SoumilBhandari/Neural-Space-Cap-Hardware/docs/DESIGN_NOTES.md

# Design notes

Why the parts are shaped the way they are, and what is still unverified.

## The head model is an ellipsoid, and says so

Three tape measurements solve for three semi-axes, so the model reproduces the
arcs it was fitted from exactly. It has no brow, no occipital bump, and perfect
left-right symmetry, none of which a real head has.

That is a defensible approximation for placing holders on a fabric cap, which
has a few millimetres of give anyway. What makes it honest rather than sloppy
is that the tool reports its own error: the 10-20 standard fixes T7 twice over,
by two different arcs, and how far apart those land is a direct measure of how
ellipsoid-like this particular head is. Across the range of heads tested it
comes out at 1-2 mm. Above 5 mm the tool tells the operator to stop trusting it
and mark by tape.

## Why a spider spring and not a foam pad

The obvious way to hold an electrode against a scalp is a foam pad and a tight
cap. It does not work well: cap tension varies with how the cap is put on, it
is different at every site, and it drops as the fabric relaxes over a session.
The failure is silent — the recording just gets noisier.

The spider spring decouples contact pressure from cap tension. The rim is sewn
to the fabric, the hub floats on three spiral arms, and the arms set the load.
Every site gets the same pressure, and it stays the same for as long as the
subject wears it.

It also prints flat with no supports and no overhangs, which matters when the
team will print a dozen of them and iterate on the spring rate.

## The frame is generated, and that is the point

Nothing about the frame is drawn by hand. Three tape measurements produce an
ellipsoid, the ellipsoid produces the 10-20 arcs, and the arcs produce the band
paths that the frame sweeps along. A different head gives a different frame
from the same source file.

That is worth the extra machinery for one reason: a frame drawn once to fit one
person's head is a frame that fits one person. The team has six members and
will want to record more than one of them.

The mount rotations come out of the same model. The outward normal of an
ellipsoid at a point is just the gradient, and `nsc_fit` converts it into the
two rotations that stand an OpenSCAD cylinder up along it, so every electrode
socket points straight out of the skull rather than being eyeballed.

## The montage is the team's, not the textbook's

The frame carries the eight sites the team specified: Fpz, F3, F4, C3, Cz, C4,
P3 and P4. Three of those — F4, Cz and P3 — are wired first while the circuit
is a single channel, and their sockets stand 2.5 mm proud of the others so they
can be found by hand without a drawing.

Carrying them needed two more arches. F3, F4, P3 and P4 sit on neither the ring
nor either original arch, so the frame gained the standard frontal
(F7-F3-Fz-F4-F8) and parietal (P7-P3-Pz-P4-P8) chains. Both land on the ring at
their ends, so they brace it rather than hanging off it.

Those two chains are not planar ellipses — F3 and P3 are defined as lying
between two other sites, so the curve through them has no closed form.
Interpolating in a plane and projecting afterwards would sag the path inside
the skull between control points, so the path is interpolated on a unit sphere,
where the shortest route between two points is a great-circle arc with an exact
formula, and mapped back onto the ellipsoid afterwards.

## The phase-one marker moved twice

First attempt: a sphere on the side of the socket boss, at boss_d/2 - 1.5.
That is inside the boss radius, so it rendered, existed in the mesh, and was
completely invisible and unfeelable.

Second attempt: the same sphere at boss_d/2 + 0.5, standing proud. That works
at some sockets and not others, because the nub points along whatever direction
the socket's local frame happens to face, and at Fpz and Cz that is straight
into a band.

What is there now: a collar extending along the socket axis, away from the
skull, where no band ever reaches. `tests/test_frame_geometry.py` measures
axial reach to confirm it, because a radial measurement cannot tell a collar
from the band the socket is sitting on.

## The LiDAR scan settled the swapped measurements

The tape numbers recorded in the team chat were 575 mm circumference, 340 mm
front-to-back and 350 mm ear-to-ear. Fitted as written they produce a head
wider across than it is long, which is unusual, and the suspicion was that the
two arc measurements had been swapped.

A LiDAR scan of the same head answers it. Principal-component analysis of the
cranium gives a long axis running front to back with a 1.14 ratio over the
short axis — longer than it is wide, the normal proportion. The measurements
were swapped. The fit uses 350 front-to-back and 340 ear-to-ear.

## Hair makes a scan a poor source of head size

The same scan is almost useless for sizing. A convex hull taken round the head
at ring height — which is what a tape measure actually follows, since a tape
bridges every dip rather than tracking into it — reads about 790 mm, against
575 mm measured by tape on the scalp. The difference is hair, and it is
200 mm of circumference, or three centimetres of radius everywhere.

How far hair compresses under a cap is not something the scan can tell us, and
it is the only number that decides whether the frame fits. So the frame ships
as a size run rather than a single part: four sizes a fixed percentage apart,
printed together, and whichever one sits right is the one that gets used. That
is cheaper than one more round of measuring, and it is the honest response to
a quantity nobody can predict.

## The divot: a tangent cut has no room for chord sag

The first scan-fitted frames had bites taken out of the bands, worst beside
the sockets — pinched waists that read as damage rather than design.

A band is swept as a hull of spheres at consecutive path points, so between
two points its surface is a straight chord, and a chord across a curve sags
inward. The band centreline was placed exactly on the surface it is cut
against, which makes the cut tangent to the centreline and leaves that sag
nowhere to go: anywhere the chord dipped, the subtraction ate into the band.
Measured sag was 0.70 mm around the lateral ring and 1.23 mm on the sagittal
arch, against a 5.5 mm band radius.

Two changes. Band paths are sampled twice as densely, which shrinks sag
quadratically; and the centreline now stands off by the liner gap plus a
1.5 mm margin, so the chord never reaches the cut. Every band now clears it
by at least 0.79 mm. The inner face is still flat against the head — the band
simply sits a little prouder of it.

The general lesson is the same one the index nub and the size badge taught:
placing a feature exactly on a boundary is placing it on the wrong side of
that boundary half the time.

## The scan has a dropout on her right, and it put a dent in the frame

A hand-held scan rarely closes evenly on both sides of a head. This one lost
her right-front quadrant, and where the data thinned the reconstruction
collapsed inward — up to 17.7 mm inside its own mirror image, smoothly across
the whole region. A skull does not do that; a scanner losing tracking does.
Unrepaired it put a visible dent in the lateral ring.

`nsc_fit.scanned.symmetrize` mirrors the height field across the sagittal
plane and keeps the larger of each pair. Larger rather than average, because a
dropout is a spurious inward collapse: the intact side carries the true
radius, and erring outward gives a cap that is slightly loose rather than one
that will not go on. Worst asymmetry after repair is 0.0 mm.

The cost is that genuine left-right asymmetry is flattened with it. For a cap
that is the right trade, but it does mean the repaired surface is no longer
purely measured, and it is why `repair_dropout` is a flag rather than
something done silently.

## A scan measures hair, and hair is not what a cap sits on

The LiDAR reads about 800 mm around the ring line. Tape on her scalp reads
575 mm. That is 36 mm of loft everywhere — a scanner recording dark hair where
it lies, uncompressed, which is not the surface a cap rests on because a cap
presses through it.

Built to the raw figure the frame came out 282 mm across: too big for any
hobby printer, and it would sit on her head like a lampshade.
`ScannedHead.scaled_to` keeps her contour — every bump, the slope of her
occiput, all of it still hers — and sets only how much hair the frame expects
to flatten.

How much that is, nobody can predict, so `make scan-sizes` prints a run.
Measured sizes, including bands and sockets:

| ring circumference | hair allowance | frame | 220 bed | 250 bed |
|---|---|---|---|---|
| 600 mm |  4.0 mm | 202 x 217 mm | no room | yes |
| 620 mm |  7.2 mm | 208 x 223 mm | no | yes |
| 640 mm (default) | 10.3 mm | 214 x 229 mm | no | yes |
| 660 mm | 13.5 mm | 220 x 236 mm | no | yes |

**Nothing that clears her hair fits a 220 mm bed.** A 250 mm machine takes any
of them. The alternative is to tie the hair back or put a thin swim cap under
it and rescan, which drops the frame to roughly 190 mm and prints anywhere.

## Two bugs the size sweep exposed

**A NaN that OpenSCAD accepted.** Surface normals are estimated by finite
differences, and at the crown the azimuthal derivative vanishes, so the cross
product is the zero vector and normalising it gives NaN. `rotate([0, nan,
nan])` does not error — it silently produces garbage, and Cz is exactly where
four bands meet, so the garbage split the frame. It fell back to the radial
direction, which at the pole is the correct normal anyway, and the build now
refuses to run if any generated parameter is NaN.

**Specks that made every connectivity check lie.** CSG where the pod pad met
the ring left four loose shells of a few triangles each, none bigger than a
quarter of a millimetre. A slicer ignores them, but they made the part report
as five pieces and buried the only question that matters — whether the frame
itself is in one piece. Sinking the pad removed the cause, and
`nsc_fit.stlclean` drops any that remain.

## The frame printed in OpenSCAD and failed in the slicer

The first STLs went into a slicer and came back with warnings about non-manifold edges and
overhangs. OpenSCAD had reported every one of those meshes as a valid
manifold, and it was right about the mesh it held in memory.

An STL has no shared vertices. It is a list of loose triangles, and the
slicer rebuilds the surface by welding corners that sit at the same position.
The frame had 89,764 vertices and 45,689 of them sat exactly on top of
another one. In memory those were separate surfaces passing through each
other's corners. After welding they were edges with four triangles on them.

Cutting the build down one piece at a time found the source: the doubling
only appeared once the scanned head was subtracted. The head mesh had a
signed volume of minus 4648 cm³. It was inside out. A boolean engine will
still subtract an inverted solid, and what comes back looks correct on
screen and is wrong everywhere the two surfaces met.

Flipping the winding took the doubled vertices from 45,689 to 49. The last
49 were all one kind of mistake, two features meeting exactly: bands of equal
diameter crossing, a collar starting on the plane its boss ended on, the size
badge starting on the pad face. Each band is now a single tube mesh with its
own radius, the boss is one cylinder, and the badge starts 0.4 mm inside the
pad.

The overhang half was the print feet. They held the ring off the bed, so the
whole ring was a bridge between eight pads. The ring is now planar with its
underside cut flat, which is a better first layer than the feet were and
needs nothing removed afterwards. Overhang past 45 degrees went from 16% of
the surface to about 10%, and what is left is the underside of the arches
near the crown, which a dome printed ring-down will always have.

One notice survived all of that. PrusaSlicer's tree supports reported a lost
branch on three of the four sizes. Cutting the frame into boxes and slicing
each one walked it down to the back pad, and slicing a frame with no size
number made it go away. The number stood 1.2 mm proud of a face tilted 62
degrees, so every stroke of every digit was a tiny overhang with nowhere for
a support to land. It is engraved two layers deep now, and sized to fit the
strip of pad between its edge and the band, where before it ran off one side
and under the band on the other. All four sizes slice with nothing reported.

What changed in the process matters more than the fix. The build now checks
the exported file the way a slicer reads it, welded by position, and stops if
it is not one closed shell. Every size and every small part is then sliced
before it is handed to anyone.

## Splitting the frame is not solved

The frame is 172 x 202 x 128 mm, which fits a 220 mm bed but not every printer,
and it needs supports under both arches.

The obvious fix — cut it in half — does not work. The sagittal arch lies
exactly in the x = 0 plane and the coronal arch lies exactly in y = 0, so a cut
on either plane runs down an arch lengthwise and produces two half-pipes rather
than two halves of a frame. The first version of this part did exactly that.

Splitting it properly means cutting transversely at the four band junctions and
designing real joints there. Until that exists, print it whole.

## What the pod is not

It is a prototype enclosure, not a flight part. It is not sealed, not
shielded, and not rated for anything. It exists so the electronics stop being a
breadboard hanging off the back of someone's head, and so the demo looks like a
device rather than a science-fair project.

If shielding turns out to be needed — Dr. Porterfield suggested better
front-end filtering as the alternative to the team's foil Faraday cage — a
conductive coating on the inside of the shell, tied to the analog ground, is
the cheapest thing to try next.

## Open questions

- **Print tolerances are unverified.** Everything in `params.scad` came from
  datasheets and typical values, not from the team's printer. Print a coupon.
- **Spring rate is a guess.** `spring_t = 0.8` at 0.2 mm layers should give a
  comfortable press, but nobody has measured the force. Print three at 0.6,
  0.8 and 1.0 and pick by feel against a scalp.
- **Cable routing is not designed.** The pod has a gland and the holders have
  slots, but the path between them across the cap is not planned. Every wire
  that failed last semester failed where it left a connector unsupported.
- **Frame stiffness is untested.** A 10 to 11 mm swept band in PETG should be stiff
  enough for a ring braced by two arches, but nobody has worn one. If it flexes,
  the cheap fix is a wider band before a thicker one.
- **The frame and the sprung holder mount differently.** The holder has a sewn
  rim for a fabric cap; the frame has a press-fit socket. Both cannot be the
  answer, and which one wins should be decided after the first fit test.
- **The cap itself is not in this repository.** The fabric pattern, the sewing,
  and the head measurements from Spring are Jia's CAD work. This repository
  covers where things go on the cap and what holds them.
