SoumilBhandari/Neural-Space-Cap-Hardware/docs/images/cap_on_head_light.png

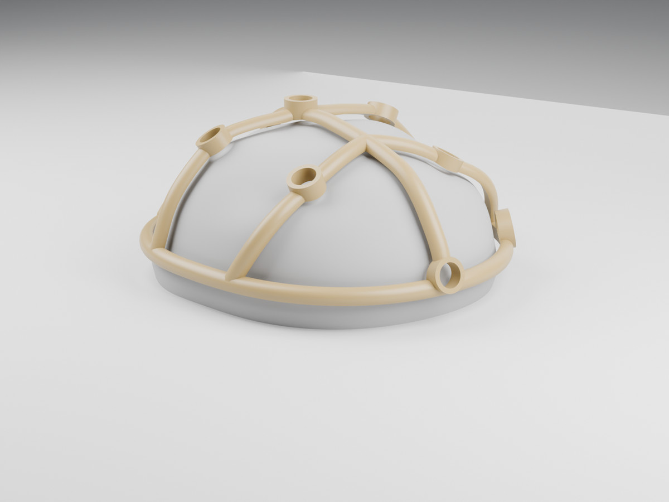
docs/images/cap_on_head_light.png
