SoumilBhandari/Neural-Space-Cap-Hardware/cad/head_params.scad

// Generated by nsc_fit — do not edit.
// Fitted from circumference 570 mm, nasion-inion 370 mm, ear-to-ear 350 mm.

head_axes = [83.409, 97.744, 136.221];
lateral_loop_len = 548.85;

band_lateral = [[-0.000, 94.117, 36.761], [-11.622, 93.127, 36.761], [-22.914, 90.205, 36.761], [-33.585, 85.493, 36.761], [-43.403, 79.190, 36.761], [-52.201, 71.526, 36.761], [-59.872, 62.733, 36.761], [-66.353, 53.028, 36.761], [-71.613, 42.609, 36.761], [-75.636, 31.653, 36.761], [-78.421, 20.318, 36.761], [-79.967, 8.749, 36.761], [-80.276, -2.919, 36.761], [-79.349, -14.554, 36.761], [-77.184, -26.024, 36.761], [-73.779, -37.188, 36.761], [-69.137, -47.896, 36.761], [-63.264, -57.982, 36.761], [-56.182, -67.257, 36.761], [-47.937, -75.514, 36.761], [-38.613, -82.526, 36.761], [-28.343, -88.062, 36.761], [-17.328, -91.900, 36.761], [-5.832, -93.869, 36.761], [5.832, -93.869, 36.761], [17.328, -91.900, 36.761], [28.343, -88.062, 36.761], [38.613, -82.526, 36.761], [47.937, -75.514, 36.761], [56.182, -67.257, 36.761], [63.264, -57.982, 36.761], [69.137, -47.896, 36.761], [73.779, -37.188, 36.761], [77.184, -26.024, 36.761], [79.349, -14.554, 36.761], [80.276, -2.919, 36.761], [79.967, 8.749, 36.761], [78.421, 20.318, 36.761], [75.636, 31.653, 36.761], [71.613, 42.609, 36.761], [66.353, 53.028, 36.761], [59.872, 62.733, 36.761], [52.201, 71.526, 36.761], [43.403, 79.190, 36.761], [33.585, 85.493, 36.761], [22.914, 90.205, 36.761], [11.622, 93.127, 36.761], [-0.000, 94.117, 36.761]];
band_sagittal = [[0.000, 94.117, 36.761], [0.000, 92.767, 42.912], [0.000, 91.198, 49.011], [0.000, 89.407, 55.049], [0.000, 87.390, 61.015], [0.000, 85.145, 66.898], [0.000, 82.666, 72.687], [0.000, 79.949, 78.368], [0.000, 76.989, 83.927], [0.000, 73.782, 89.346], [0.000, 70.324, 94.609], [0.000, 66.609, 99.693], [0.000, 62.634, 104.578], [0.000, 58.397, 109.236], [0.000, 53.897, 113.640], [0.000, 49.134, 117.759], [0.000, 44.113, 121.559], [0.000, 38.842, 125.003], [0.000, 33.334, 128.055], [0.000, 27.609, 130.674], [0.000, 21.691, 132.824], [0.000, 15.615, 134.472], [0.000, 9.418, 135.587], [0.000, 3.148, 136.150], [0.000, -3.148, 136.150], [0.000, -9.418, 135.587], [0.000, -15.615, 134.472], [0.000, -21.691, 132.824], [0.000, -27.609, 130.674], [0.000, -33.334, 128.055], [0.000, -38.842, 125.003], [0.000, -44.113, 121.559], [0.000, -49.134, 117.759], [0.000, -53.897, 113.640], [0.000, -58.397, 109.236], [0.000, -62.634, 104.578], [0.000, -66.609, 99.693], [0.000, -70.324, 94.609], [0.000, -73.782, 89.346], [0.000, -76.989, 83.927], [0.000, -79.949, 78.368], [0.000, -82.666, 72.687], [0.000, -85.145, 66.898], [0.000, -87.390, 61.015], [0.000, -89.407, 55.049], [0.000, -91.198, 49.011], [0.000, -92.767, 42.912], [0.000, -94.117, 36.761]];
band_coronal = [[-65.250, 0.000, 84.854], [-63.576, 0.000, 88.180], [-61.814, 0.000, 91.460], [-59.962, 0.000, 94.690], [-58.019, 0.000, 97.866], [-55.981, 0.000, 100.982], [-53.846, 0.000, 104.033], [-51.612, 0.000, 107.011], [-49.275, 0.000, 109.909], [-46.834, 0.000, 112.720], [-44.286, 0.000, 115.435], [-41.628, 0.000, 118.043], [-38.861, 0.000, 120.533], [-35.982, 0.000, 122.894], [-32.992, 0.000, 125.112], [-29.892, 0.000, 127.173], [-26.684, 0.000, 129.062], [-23.372, 0.000, 130.764], [-19.964, 0.000, 132.262], [-16.468, 0.000, 133.540], [-12.894, 0.000, 134.584], [-9.258, 0.000, 135.379], [-5.574, 0.000, 135.917], [-1.861, 0.000, 136.187], [1.861, 0.000, 136.187], [5.574, 0.000, 135.917], [9.258, 0.000, 135.379], [12.894, 0.000, 134.584], [16.468, 0.000, 133.540], [19.964, 0.000, 132.262], [23.372, 0.000, 130.764], [26.684, 0.000, 129.062], [29.892, 0.000, 127.173], [32.992, 0.000, 125.112], [35.982, 0.000, 122.894], [38.861, 0.000, 120.533], [41.628, 0.000, 118.043], [44.286, 0.000, 115.435], [46.834, 0.000, 112.720], [49.275, 0.000, 109.909], [51.612, 0.000, 107.011], [53.846, 0.000, 104.033], [55.981, 0.000, 100.982], [58.019, 0.000, 97.866], [59.962, 0.000, 94.690], [61.814, 0.000, 91.460], [63.576, 0.000, 88.180], [65.250, 0.000, 84.854]];
band_frontal = [[-66.646, 52.522, 36.761], [-65.045, 53.946, 40.238], [-63.365, 55.303, 43.666], [-61.606, 56.592, 47.040], [-59.772, 57.811, 50.356], [-57.864, 58.959, 53.610], [-55.885, 60.034, 56.798], [-53.837, 61.035, 59.916], [-51.722, 61.962, 62.960], [-49.544, 62.811, 65.927], [-47.305, 63.584, 68.812], [-45.008, 64.278, 71.613], [-42.655, 64.893, 74.325], [-40.250, 65.428, 76.946], [-37.795, 65.882, 79.472], [-35.293, 66.256, 81.900], [-32.748, 66.547, 84.227], [-30.163, 66.757, 86.451], [-27.540, 66.885, 88.568], [-24.884, 66.930, 90.576], [-22.197, 66.892, 92.472], [-19.482, 66.773, 94.255], [-16.744, 66.571, 95.921], [-13.985, 66.287, 97.469], [-11.209, 65.921, 98.898], [-8.419, 65.474, 100.204], [-5.618, 64.947, 101.387], [-2.811, 64.339, 102.445], [0.000, 63.652, 103.377], [2.811, 64.339, 102.445], [5.618, 64.947, 101.387], [8.419, 65.474, 100.204], [11.209, 65.921, 98.898], [13.985, 66.287, 97.469], [16.744, 66.571, 95.921], [19.482, 66.773, 94.255], [22.197, 66.892, 92.472], [24.884, 66.930, 90.576], [27.540, 66.885, 88.568], [30.163, 66.757, 86.451], [32.748, 66.547, 84.227], [35.293, 66.256, 81.900], [37.795, 65.882, 79.472], [40.436, 65.390, 76.748], [43.020, 64.804, 73.914], [45.543, 64.125, 70.974], [48.000, 63.354, 67.933], [50.389, 62.494, 64.795], [52.706, 61.543, 61.564], [54.948, 60.505, 58.246], [57.111, 59.381, 54.844], [59.193, 58.172, 51.364], [61.190, 56.879, 47.811], [63.099, 55.506, 44.189], [64.919, 54.053, 40.504], [66.646, 52.522, 36.761]];
band_parietal = [[-66.646, -52.522, 36.761], [-65.045, -53.946, 40.238], [-63.365, -55.303, 43.666], [-61.606, -56.592, 47.040], [-59.772, -57.811, 50.356], [-57.864, -58.959, 53.610], [-55.885, -60.034, 56.798], [-53.837, -61.035, 59.916], [-51.722, -61.962, 62.960], [-49.544, -62.811, 65.927], [-47.305, -63.584, 68.812], [-45.008, -64.278, 71.613], [-42.655, -64.893, 74.325], [-40.250, -65.428, 76.946], [-37.795, -65.882, 79.472], [-35.293, -66.256, 81.900], [-32.748, -66.547, 84.227], [-30.163, -66.757, 86.451], [-27.540, -66.885, 88.568], [-24.884, -66.930, 90.576], [-22.197, -66.892, 92.472], [-19.482, -66.773, 94.255], [-16.744, -66.571, 95.921], [-13.985, -66.287, 97.469], [-11.209, -65.921, 98.898], [-8.419, -65.474, 100.204], [-5.618, -64.947, 101.387], [-2.811, -64.339, 102.445], [0.000, -63.652, 103.377], [2.811, -64.339, 102.445], [5.618, -64.947, 101.387], [8.419, -65.474, 100.204], [11.209, -65.921, 98.898], [13.985, -66.287, 97.469], [16.744, -66.571, 95.921], [19.482, -66.773, 94.255], [22.197, -66.892, 92.472], [24.884, -66.930, 90.576], [27.540, -66.885, 88.568], [30.163, -66.757, 86.451], [32.748, -66.547, 84.227], [35.293, -66.256, 81.900], [37.795, -65.882, 79.472], [40.436, -65.390, 76.748], [43.020, -64.804, 73.914], [45.543, -64.125, 70.974], [48.000, -63.354, 67.933], [50.389, -62.494, 64.795], [52.706, -61.543, 61.564], [54.948, -60.505, 58.246], [57.111, -59.381, 54.844], [59.193, -58.172, 51.364], [61.190, -56.879, 47.811], [63.099, -55.506, 44.189], [64.919, -54.053, 40.504], [66.646, -52.522, 36.761]];

// [name, position, [rot_x, rot_y, rot_z], phase_one]
mounts = [
    ["Fpz", [0.000, 94.117, 36.761], [0, 78.630, 90.000], 0],
    ["F3", [-37.795, 65.882, 79.472], [0, 63.994, 128.230], 0],
    ["F4", [37.795, 65.882, 79.472], [0, 63.994, 51.770], 1],
    ["C3", [-56.603, 0.000, 100.054], [0, 56.466, 180.000], 0],
    ["Cz", [0.000, -0.000, 136.221], [0, 0.000, -90.000], 1],
    ["C4", [56.603, 0.000, 100.054], [0, 56.466, 0.000], 0],
    ["P3", [-37.795, -65.882, 79.472], [0, 63.994, -128.230], 1],
    ["P4", [37.795, -65.882, 79.472], [0, 63.994, -51.770], 0]
];

ppg_mount = [[-53.587, 70.105, 36.761], [0, 79.451, 136.388]];

pod_anchor = [[-0.000, -94.117, 36.761], [0, 78.630, -90.000]];
