SoumilBhandari/Neural-Space-Cap-Hardware/(commit log)

2026-09-04 Add head fitting, 10-20 montage, and the printed parts
    nsc_fit solves an ellipsoid head from three tape measurements and places
    the International 10-20 sites on it, then emits a marking template that
    prints at 1:1 and wraps around a head. This is what makes electrode
    placement repeatable between sessions; a sensor taped on by hand sits
    somewhere different every time, and that movement is indistinguishable
    from the subject's physiology changing.
    The 10-20 standard fixes T7 twice over, by two different arcs, so the
    tool reports how far apart those land as its own error bar and tells the
    operator to mark by tape instead when it gets large. Measurements that
    are not head-shaped are rejected up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
    [electrode_holder.scad, electronics_pod.scad, params.scad, sensor_puck.scad]
2026-09-04 Generate the cap frame from the fitted head
    The frame is the part that actually goes on a head: a closed ring at
    Fpz/Oz level braced by two arches, carrying electrode sockets at O1, O2
    and Fp1 and a pad for the electronics pod behind Oz. Ring plus arches
    rather than separate front and rear bands, because a band joined only at
    the midline is cantilevered and flexes, and an electrode that moves is
    an electrode whose data cannot be compared between sessions.
    nsc_fit now writes the fitted head out as OpenSCAD data — semi-axes,
    band paths as polylines, and each mount as a point plus the rotations
    that stand a cylinder up along the surface normal. The CAD only has to
    sweep and subtract, so re-m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
    [cap_frame.scad, head_params.scad]
2026-10-02 Carry the team's eight-electrode montage on the frame
    The frame now mounts Fpz, F3, F4, C3, Cz, C4, P3 and P4, plus a seat for
    the PPG sensor on the temple. F4, Cz and P3 are wired first while the
    circuit is a single channel, so their sockets stand proud of the others
    and can be found by hand.
    F3, F4, P3 and P4 sit on neither the ring nor either existing arch, so
    the frame gained the frontal and parietal chains. Those curves have no
    closed form, since F3 and P3 are defined as lying between two other
    sites, so they are interpolated as great-circle arcs on a unit sphere
    and mapped back onto the ellipsoid, which keeps every sampled point on
    the head instead of sagging inside it.
    Mounts are no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
    [cap_frame.scad, head_params.scad]
2026-10-02 Add Blender renders and turntable animations
    Four stills and two clips, driven headless so they regenerate after a
    design change instead of being screenshotted once and going stale.
    Purdue old gold on a dark cove. Base colours are deliberately low:
    Cycles is physically based and these are lit hard, so an 0.8 albedo
    clips to white and every part in the shot becomes the same pale blob.
    Framing is derived from the subject's projected bounding box rather than
    per-shot numbers, so a design change that grows the frame cannot crop it
    out of the picture. A bounding sphere was tried first and strands a dome
    in the middle of an empty picture.
    The backdrop is a cove revolved around the subject. A fl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
2026-10-09 Add a printable size run, and correct the swapped head measurements
    The LiDAR scan settles a question left open in the chat. The tape numbers
    were recorded as 340 mm front-to-back and 350 mm ear-to-ear, which fitted
    as written give a head wider across than it is long. PCA of the scanned
    cranium gives a front-to-back long axis at a 1.14 ratio — the normal
    proportion — so the two arcs were swapped. Defaults corrected.
    The same scan is almost useless for sizing. A convex hull round it at ring
    height reads about 790 mm against 575 mm by tape on the scalp, and the
    difference is hair. How far hair compresses under a cap decides whether
    the frame fits, and the scan cannot predict it, so opensc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
2026-10-09 Fit the frame to her scanned head instead of to an ellipsoid
    The ellipsoid is a generic head of the right size, and scaling it up to
    clear hair just makes a bigger generic head. nsc_fit.scanned isolates the
    cranium from the LiDAR scan, aligns it, and resamples it into a polar
    height field, which the frame is then built on and hollowed against — so
    the inside of the print follows her contour, including the side where her
    hair is thicker. C3 lands at -63 mm and C4 at +70 mm, which an ellipsoid
    cannot represent.
    The 10-20 layout still comes from the fitted ellipsoid, because the
    standard is defined by arc percentages between bony landmarks and nothing
    on this scan marks them. Each site's dir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
2026-10-09 Stop the subtraction biting chunks out of the bands
    A band is swept as a hull of spheres at consecutive path points, so
    between two points its surface is a straight chord, and a chord across a
    curve sags inward. The centreline sat exactly on the surface it is cut
    against, which makes the cut tangent to it and leaves the sag nowhere to
    go — anywhere the chord dipped, the subtraction ate into the band and
    left a pinched waist that reads as damage.
    Measured sag was 0.70 mm around the lateral ring and 1.23 mm on the
    sagittal arch, against a 5.5 mm band radius.
    Band paths are now sampled twice as densely, which shrinks sag
    quadratically, and the centreline stands off by the liner gap plus a
    1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
2026-10-09 Repair the scan dropout that dented the frame
    The scan lost her right-front quadrant and the reconstruction collapsed
    inward there — up to 17.7 mm inside its own mirror image, smoothly across
    the whole region. That is a scanner losing tracking, not a skull, and it
    put a visible dent in the lateral ring.
    The height field is now mirrored across the sagittal plane, keeping the
    larger of each pair. Larger rather than average: a dropout is a spurious
    inward collapse, so the intact side carries the true radius, and erring
    outward gives a cap that is loose rather than one that will not go on.
    Worst remaining asymmetry 0.0 mm.
    Genuine asymmetry is flattened along with the artifact, so this is a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
2026-10-09 Make the scan-fitted cap printable, and fix two silent bugs
    The frame was 282 mm across because it was built to the raw LiDAR hair
    surface. The scan reads about 800 mm around the ring line against 575 mm
    of tape on her scalp — 36 mm of uncompressed loft everywhere, which is
    not the surface a cap rests on. ScannedHead.scaled_to keeps her contour
    and sets only how much hair the frame expects to flatten.
    At the 640 mm default the frame is 214 x 229 x 99 mm. Nothing that clears
    her hair fits a 220 mm bed; a 250 mm machine takes any of the run.
    Two bugs found by sweeping sizes:
    - Surface normals are finite differences, and at the crown the azimuthal
    derivative vanishes, so the normal came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
2026-10-09 Four printable sizes, and stop trying to repair meshes by hand
    make scan-sizes builds 600/620/640/660 mm, spanning 4 to 13.5 mm of hair
    allowance. All four are single watertight shells, each with its
    circumference raised on the pod pad. They go to build/scan_sizes/ rather
    than build/sizes/, which still holds the older ellipsoid-scaled run —
    mixing them meant a render picked up eleven frames instead of four.
    stlclean now only drops connected shells other than the largest, which is
    the one repair that is provably safe. The tidier passes are off and
    documented as staying off:
    OpenSCAD's export is ugly — a quarter of its triangles are exact
    duplicates and a third of edges are shared by fou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
2026-10-09 Pick the size run by hair compression, not by bed size
    The 600-660 range was capped by an assumed 250 mm bed. The printer in
    play is a Bambu H2D at 325 x 320 mm, which takes any of these with at
    least 64 mm to spare, so the spread should bracket the actual unknown
    instead.
    Her scan carries 36 mm of hair loft. The run now spans 620 to 740 mm,
    flattening that by about 80% down to about 27%, which covers the range a
    rigid band plausibly achieves on thick hair.
    build_scan also reports solid volume now, by the divergence theorem
    rather than from the bounding box: these are 190-230 cm3 each, so the
    four together are most of a spool.
2026-10-09 Make the frame actually printable: feet, a fit coupon, and a real press fit
    Three things stood between this model and a successful print.
    The frame is a swept tube on a curved path, so nothing on it is flat.
    Ring-down it met the plate at a single tangent point with 0.0 mm2 of
    first-layer area, which no brim can rescue because there is nothing for a
    brim to hold. That is the ordinary reason a generated model refuses to
    print. Eight sacrificial feet now give it 2032 mm2 across well-spread
    pads, cut flat against the same plane that trims the frame, and the
    part's centre of mass sits inside them so it cannot rock.
    The first attempt at feet derived a plate height from the ring and left
    the pads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
2026-10-09 Size thin features in printer units for a 0.4 mm nozzle
    A slicer cannot lay down a fraction of a line, so features near the
    nozzle size are now whole multiples of extrusion width or layer height
    rather than round numbers.
    The holder's flexure was 0.80 mm, which a 0.42 mm line rounds up to 0.84.
    Stiffness goes as the cube of thickness, so the spring would have come
    out 16% firmer than the figure it was designed to. It is 2 * line_w now,
    and asking for 0.84 gets 0.84.
    The foot neck was 3.5 mm — strong enough to need real force to cut, with
    the band right next to it. Six extrusion widths holds the print down
    just as well and parts under flush cutters in one squeeze. The foot pad
    is three wh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
2026-10-29 Rewrite the README around what the project actually does
    The old one described a tape-measure template. The repository now takes a
    LiDAR scan of a specific head and produces print-ready STLs fitted to it,
    and the README did not say so or show it.
    Adds eleven images: the fitted cap from three angles, the montage, the
    size run, the printed parts, and the figures from the scan pipeline that
    explain the steps that are not obvious, such as why the mesh has to be
    welded and why the shape-based face detection failed.
    Also adds a table of the bugs that rendered perfectly and were still
    wrong, with how each was caught, since that is the most transferable
    thing in the repository.
    Images are untextu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
2026-10-29 Give the README an animated hero
    Waving capsule-render banner in the project's own colours, cycling
    typing-svg taglines, status badges, a skillicons tech row, and a 44-frame
    turntable GIF of the fitted cap.
    The hero still render swaps with prefers-color-scheme, so it reads
    correctly on both GitHub themes: the render script already had a light
    theme, so the light variant is a real render rather than an inverted
    image.
    The GIF is assembled from Blender PNG frames with Pillow, since there is
    no ffmpeg on this machine, and quantised to 96 colours at 460 px to keep
    it to 2 MB.
    Flashy header, then substance immediately: everything below the fold is
    unchanged.
2026-11-11 Fix non-manifold frame and print overhangs
    The scan head was exported inside out (signed volume -4648 cm3), so
    subtracting it left 45,689 of the frame's 89,764 vertices doubled. A slicer
    welds by position and reported those as non-manifold edges. The exporter now
    flips the winding when the volume is negative.
    Remaining coincident geometry removed: each band is one closed tube mesh with
    its own radius, socket bosses are a single cylinder, the size badge starts
    inside the pad.
    Print feet replaced by a planar ring cut flat on its underside: 3160 mm2 of
    first layer on the 660 frame, overhang past 45 degrees down from 16% to 10%.
    Sensor puck exports ears-down with a coned cavity step, fit coup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
2026-11-11 Keep the coupon engraving clear of the socket boss
2026-11-11 Re-render the README images with the flat-ring frame
2026-11-11 Rest size-run frames on the build plate
    The frame is modelled in the head's coordinates, so its flat ring sat 17 to
    20 mm above zero in the exported file. The size run now shifts each frame to
    z = 0 and centres it, in float32 so the mesh stays welded.
2026-11-11 Engrave the size number so the frame slices with no warnings
    The raised digits on the tilted pod pad each had a small overhang that tree
    supports could not reach, which PrusaSlicer reported as a lost branch on
    three of the four sizes. Engraved two layers deep and sized to fit the clear
    strip of pad beside the band. All four sizes now slice with nothing reported.
